radmancer/herzog/lowes_screw_cabinet.JPG

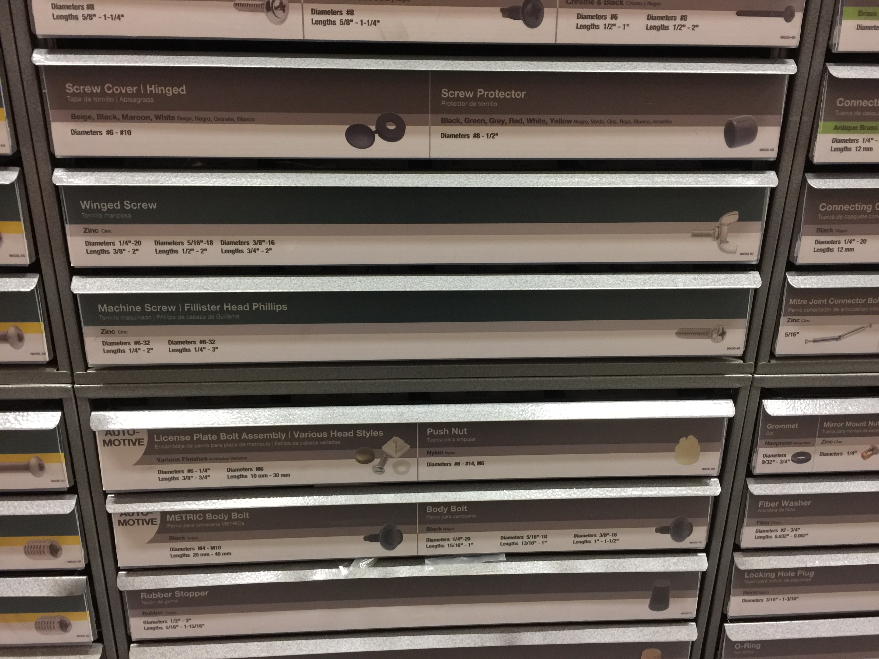
lowes_screw_cabinet.JPG
