radmancer/herzog/silver_screws.JPG

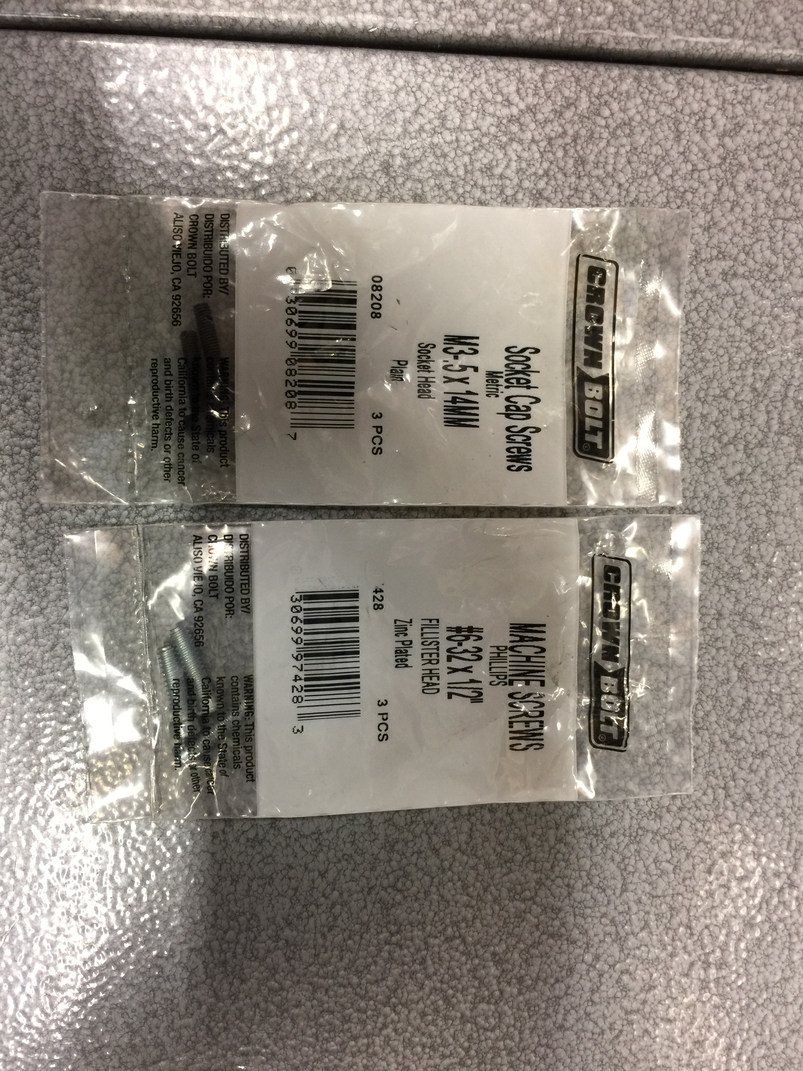
silver_screws.JPG
