radmancer/herzog/README.md

# herzog
2nd attempt at creating a prosthetic hand.
