radmancer/herzog/soon.png

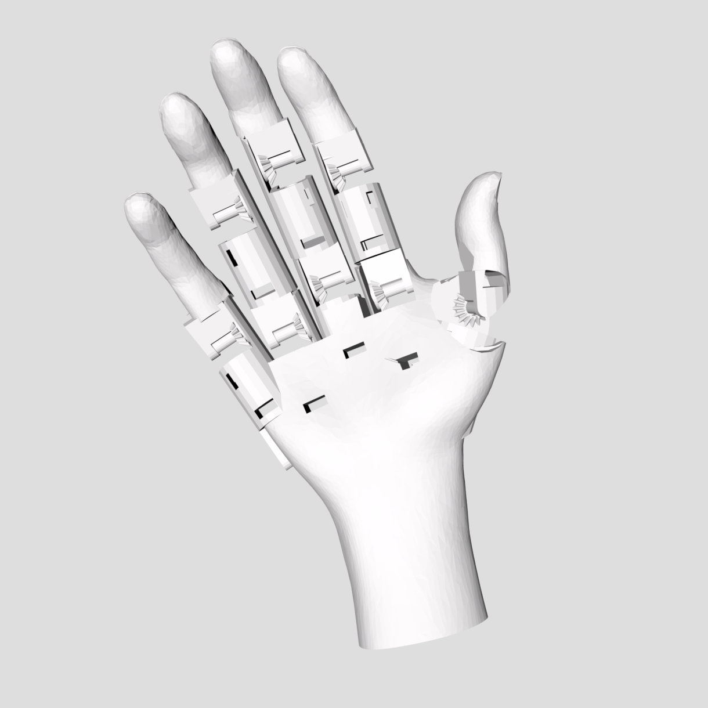
soon.png
