radmancer/herzog/soon_side_view.png

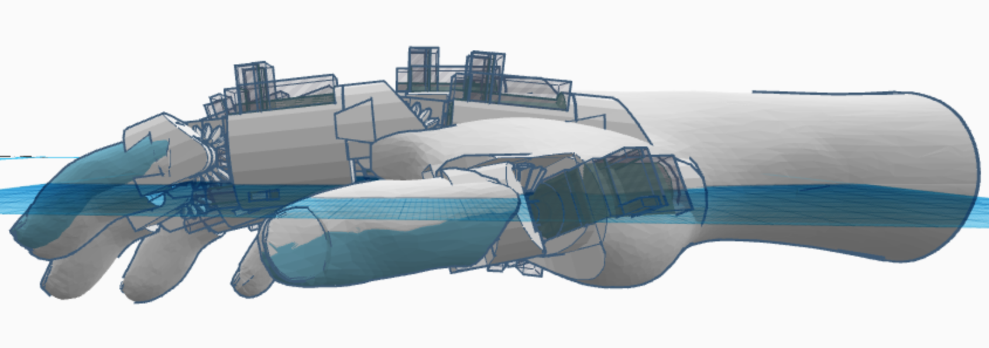
soon_side_view.png
