radmancer/herzog/herzog_index.stl

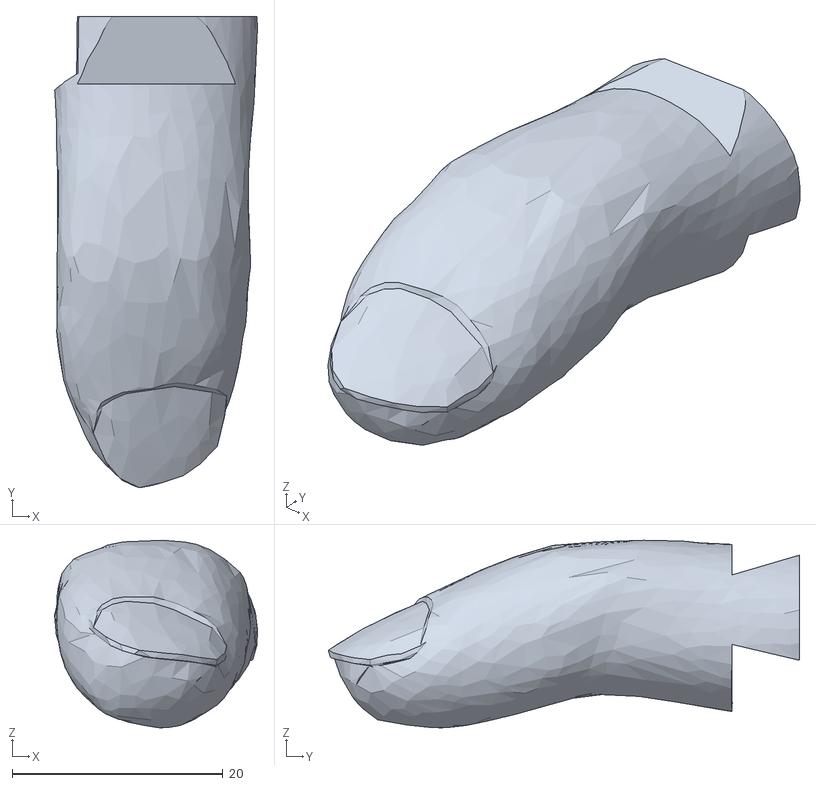
[picture p5: CAD file, 2018-05-17]
herzog_index.stl
19.3 x 44.7 x 17.8
