radmancer/herzog/herzog_ring.stl

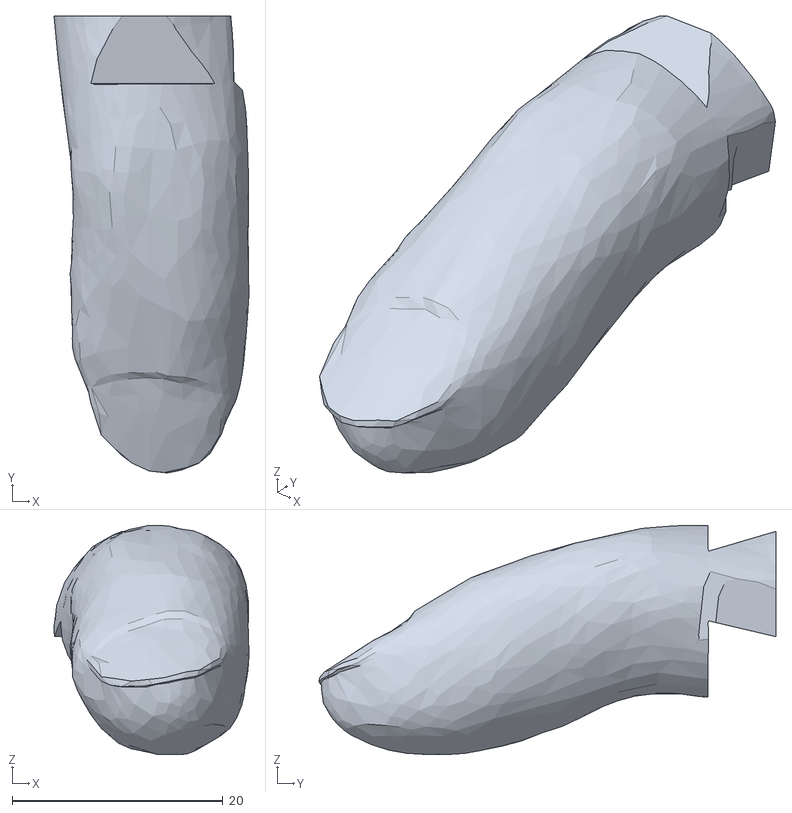
[picture p6: CAD file, 2018-05-17]
herzog_ring.stl
18.5 x 43.4 x 21.8
