radmancer/herzog/herzog_pinky.stl

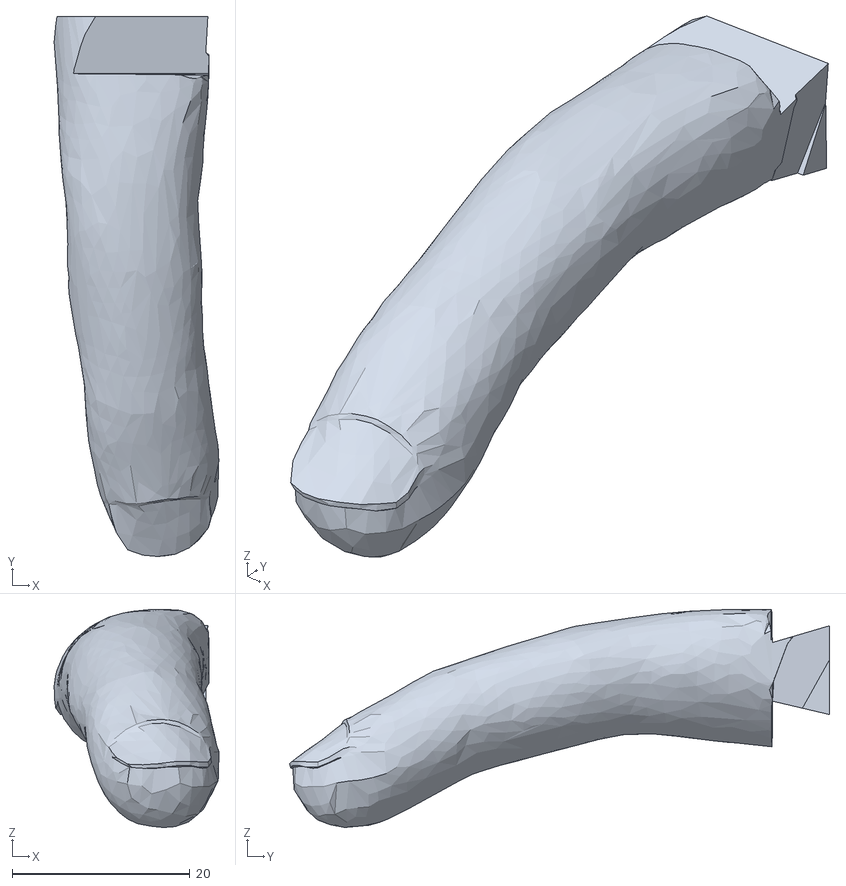
[picture p7: CAD file, 2018-05-17]
herzog_pinky.stl
18.5 x 60.8 x 24.5
