radmancer/herzog/herzog_middle.stl

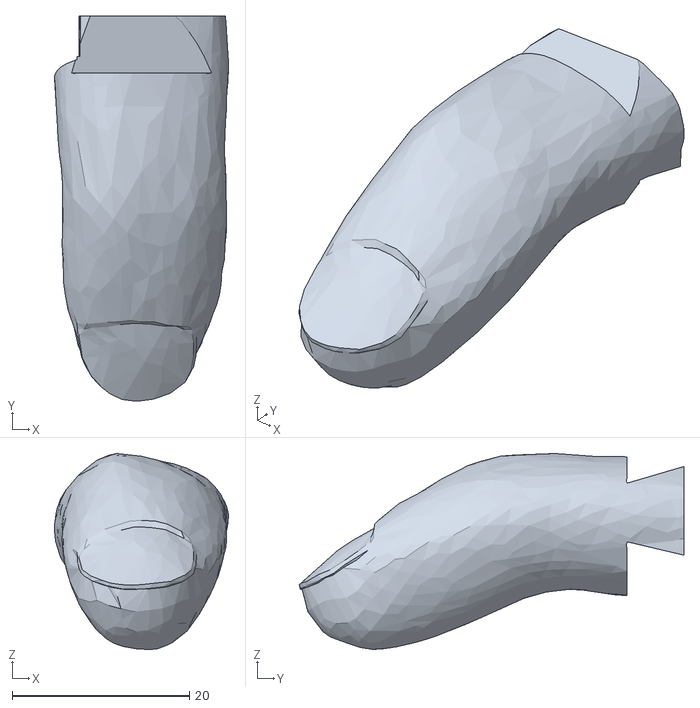
[picture p8: CAD file, 2018-05-17]
herzog_middle.stl
19.7 x 43.4 x 22.1
