radmancer/herzog/herzog_thumb.stl

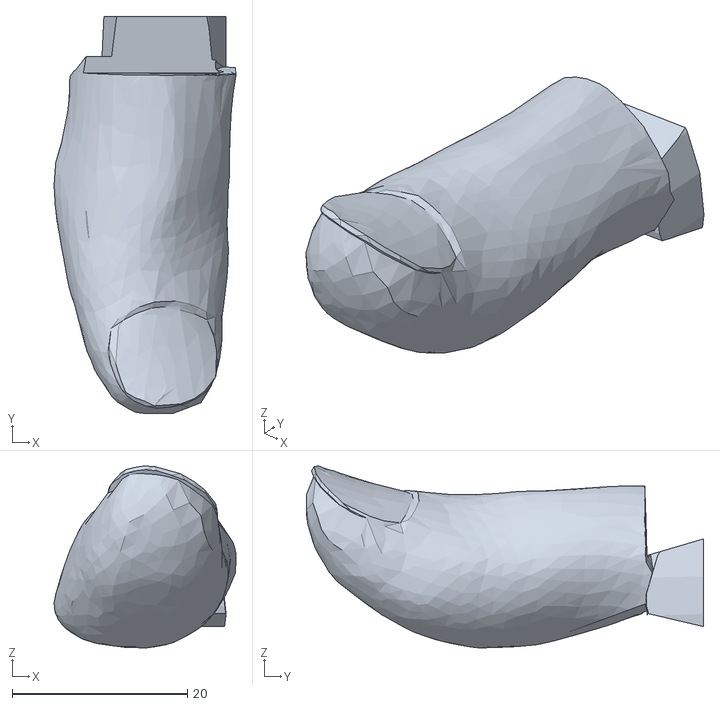
[picture p9: CAD file, 2018-05-17]
herzog_thumb.stl
20.7 x 45.3 x 20.7
