radmancer/herzog/final_batan_b2122.stl

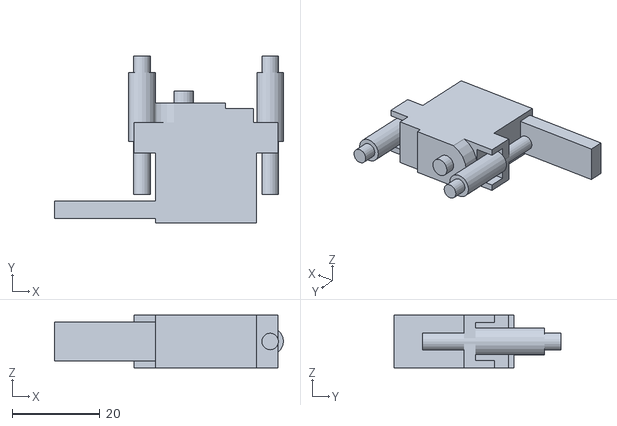
[picture p10: CAD file, 2018-02-20]
final_batan_b2122.stl
52.3 x 38.2 x 12.0
