radmancer/herzog/batan_b2122.stl

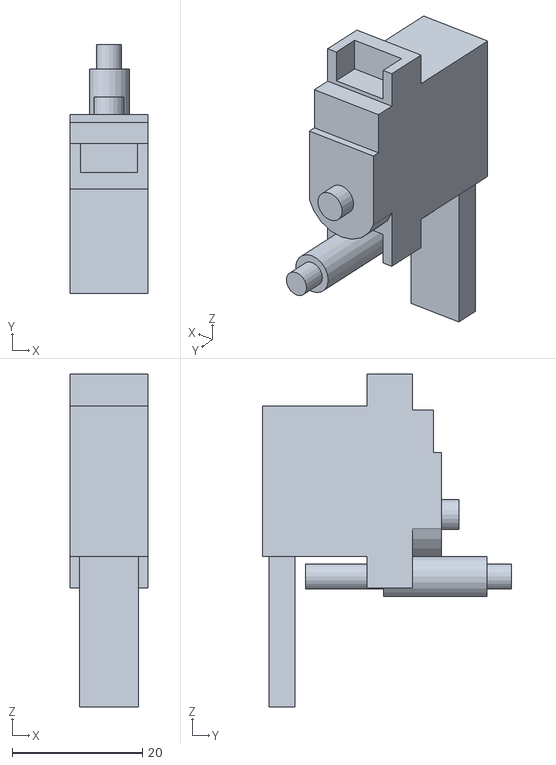
[picture p11: CAD file, 2018-02-20]
batan_b2122.stl
12.0 x 38.2 x 51.0
