radmancer/herzog/herzog_palm.stl

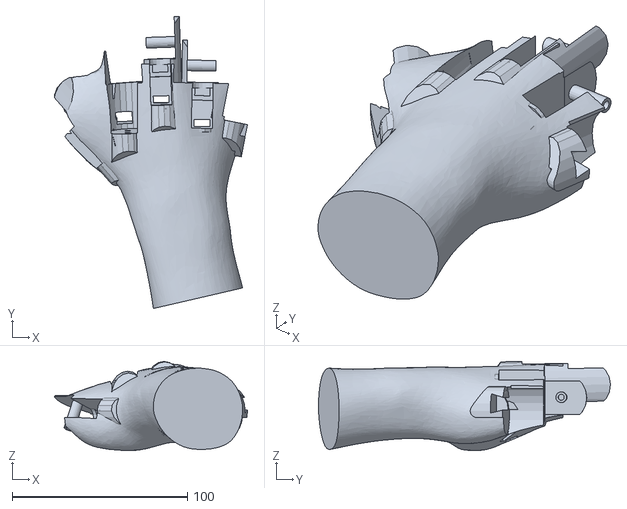
[picture p12: CAD file, 2017-09-12]
herzog_palm.stl
110.3 x 166.7 x 50.9
