radmancer/herzog/sawnoff_male_gimble_body.stl

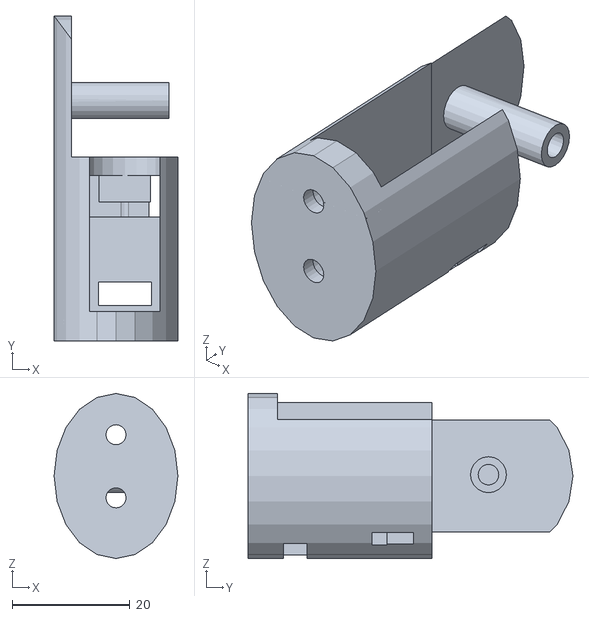
[picture p13: CAD file, 2017-09-12]
sawnoff_male_gimble_body.stl
21.0 x 55.1 x 28.0
