radmancer/herzog/male_gimble.stl

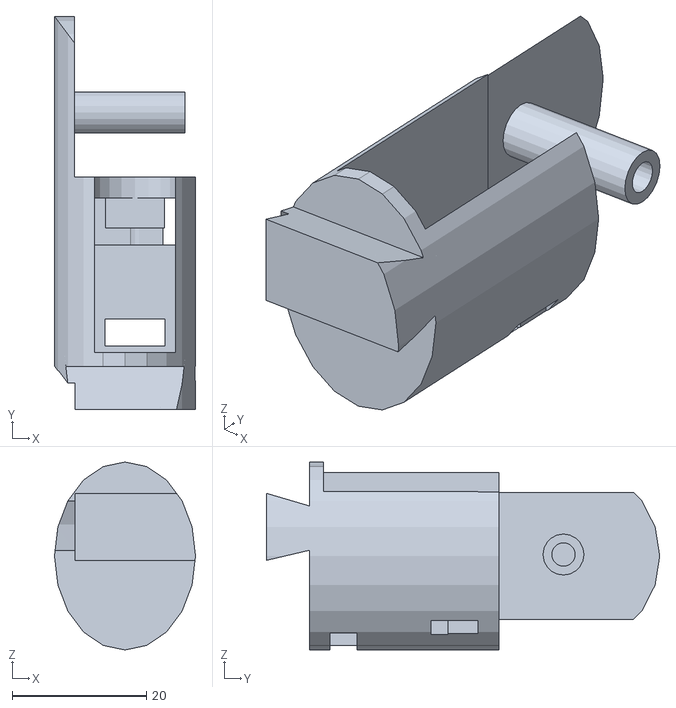
[picture p14: CAD file, 2017-08-21]
male_gimble.stl
21.0 x 58.6 x 28.0
