radmancer/herzog/herzog.stl

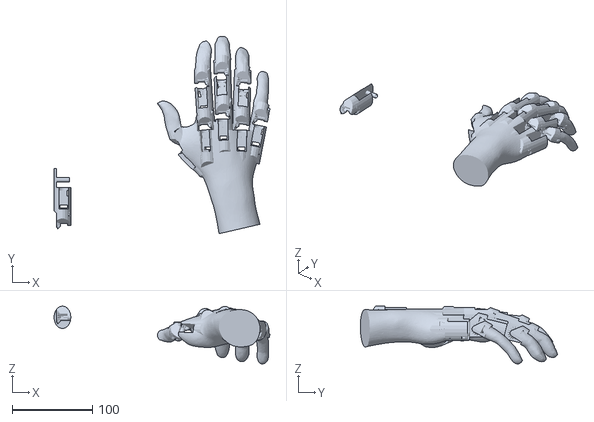
[picture p15: CAD file, 2017-08-21]
herzog.stl
268.6 x 245.5 x 72.0
