radmancer/herzog/female_gimble.stl

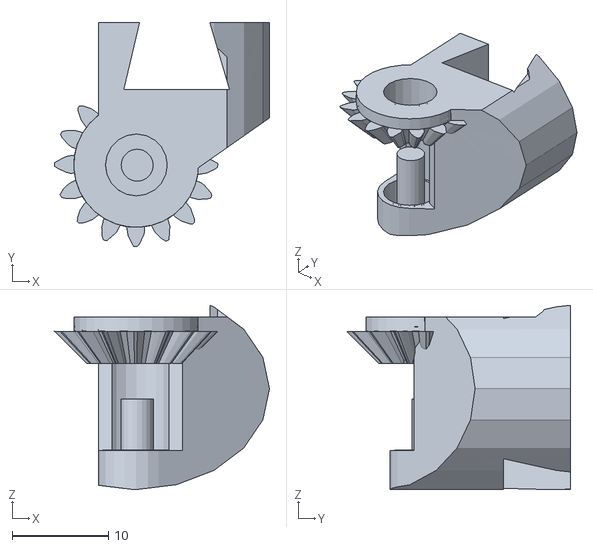
[picture p16: CAD file, 2017-08-21]
female_gimble.stl
22.4 x 23.3 x 19.2
