radmancer/herzog/uv_resin_driver_gear.stl

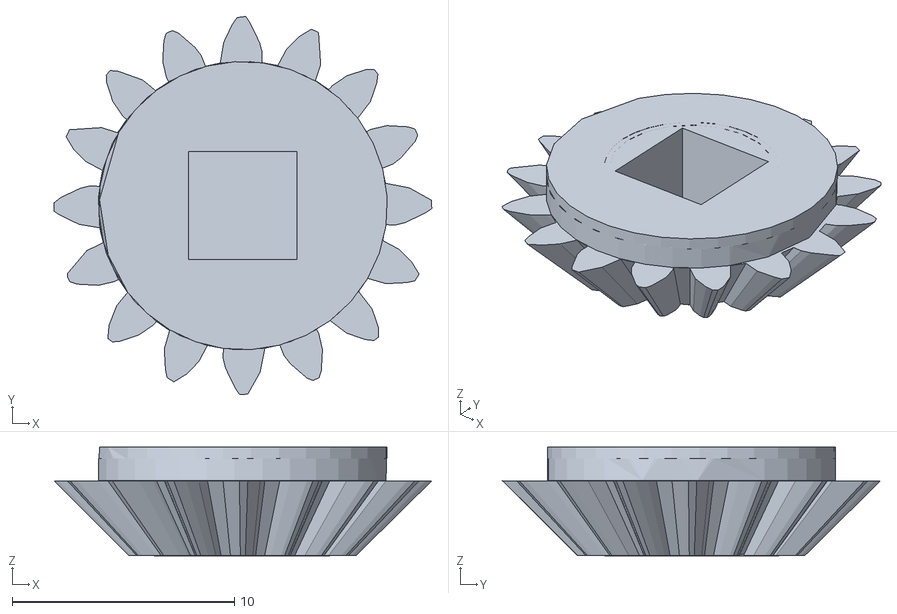
[picture p17: CAD file, 2017-08-21]
uv_resin_driver_gear.stl
17.0 x 17.0 x 4.90
