radmancer/herzog/(commit log)

2017-08-31 Add files via upload
    "Silver Screws" means that you should purchase the silver screws in the image, and not the black screws.
    These screws can be found at Lowes in their machine screws section pictured in "lowes_screw_cabinet.JPG"
2018-02-20 A blank of the servo used in this project.
    [batan_b2122.stl]
2018-05-17 All finger geometry
    I forgot to upload these fingertips with the initial push.
    Here they are!
    [herzog_index.stl, herzog_middle.stl, herzog_pinky.stl, herzog_ring.stl, herzog_thumb.stl]
